ademuri/kelvin-kontroller/hardware/ref/kelvin-kontroller back.png

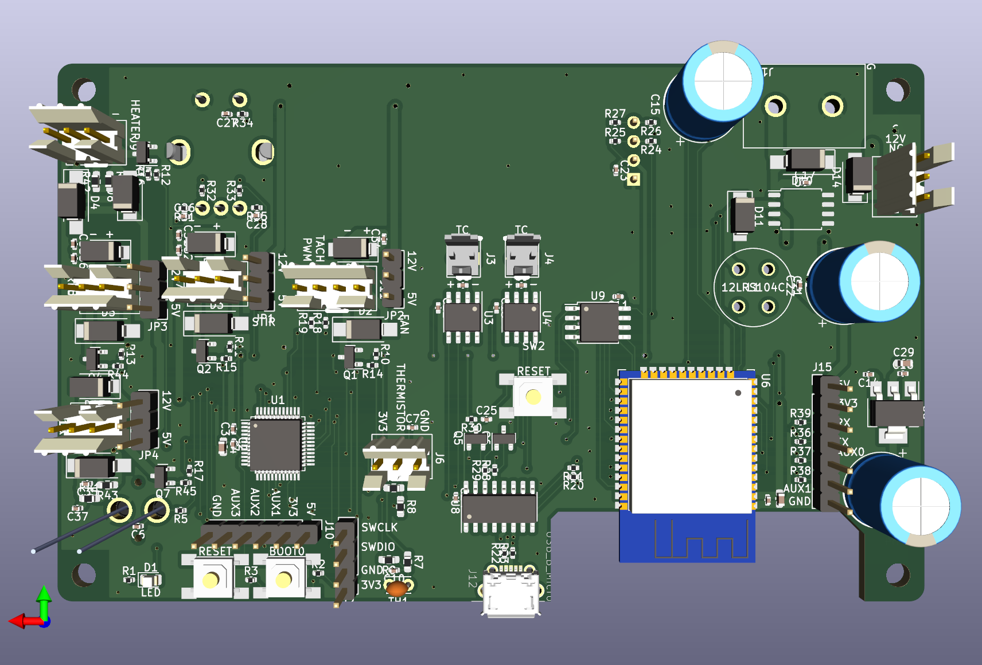
hardware/ref/kelvin-kontroller back.png
