ademuri/kelvin-kontroller/README.md

# Kelvin Kontroller

DIY coffee roaster. Custom PCB which controls and monitors the roaster. Has a WiFi dashboard.
