ademuri/kelvin-kontroller/hardware/ref/calculations.md

SSR safety: https://www.ia.omron.com/product/cautions/18/safety_precautions.html

Bleeder resistor:
R <= E / (I_L - I) = 0.5 / (1 uA - ??) -> 0.5 / (1 uA) = 500k
