ademuri/kelvin-kontroller/hardware/ref/kelvin-kontroller front.png

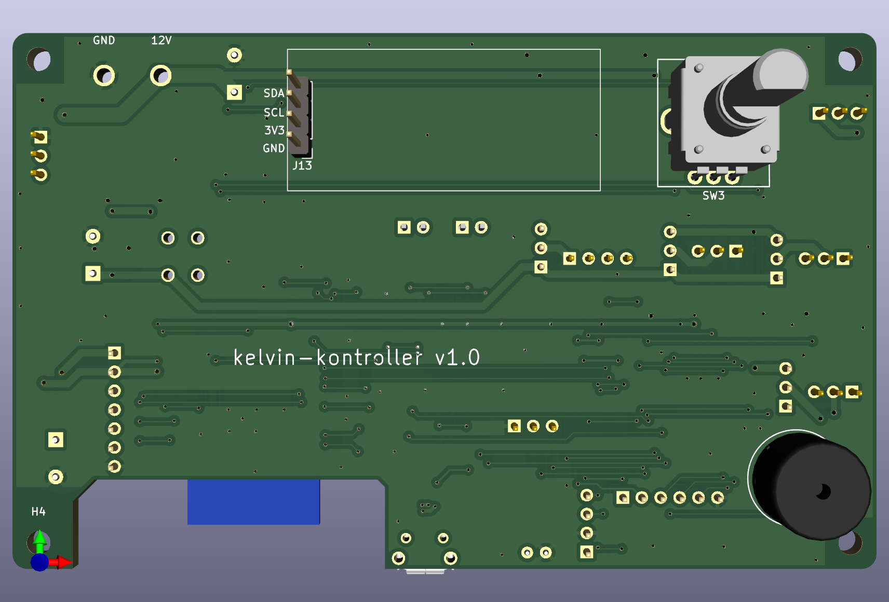
hardware/ref/kelvin-kontroller front.png
