ademuri/kelvin-kontroller/hardware/ref/kelvin-kontroller-controller.pdf

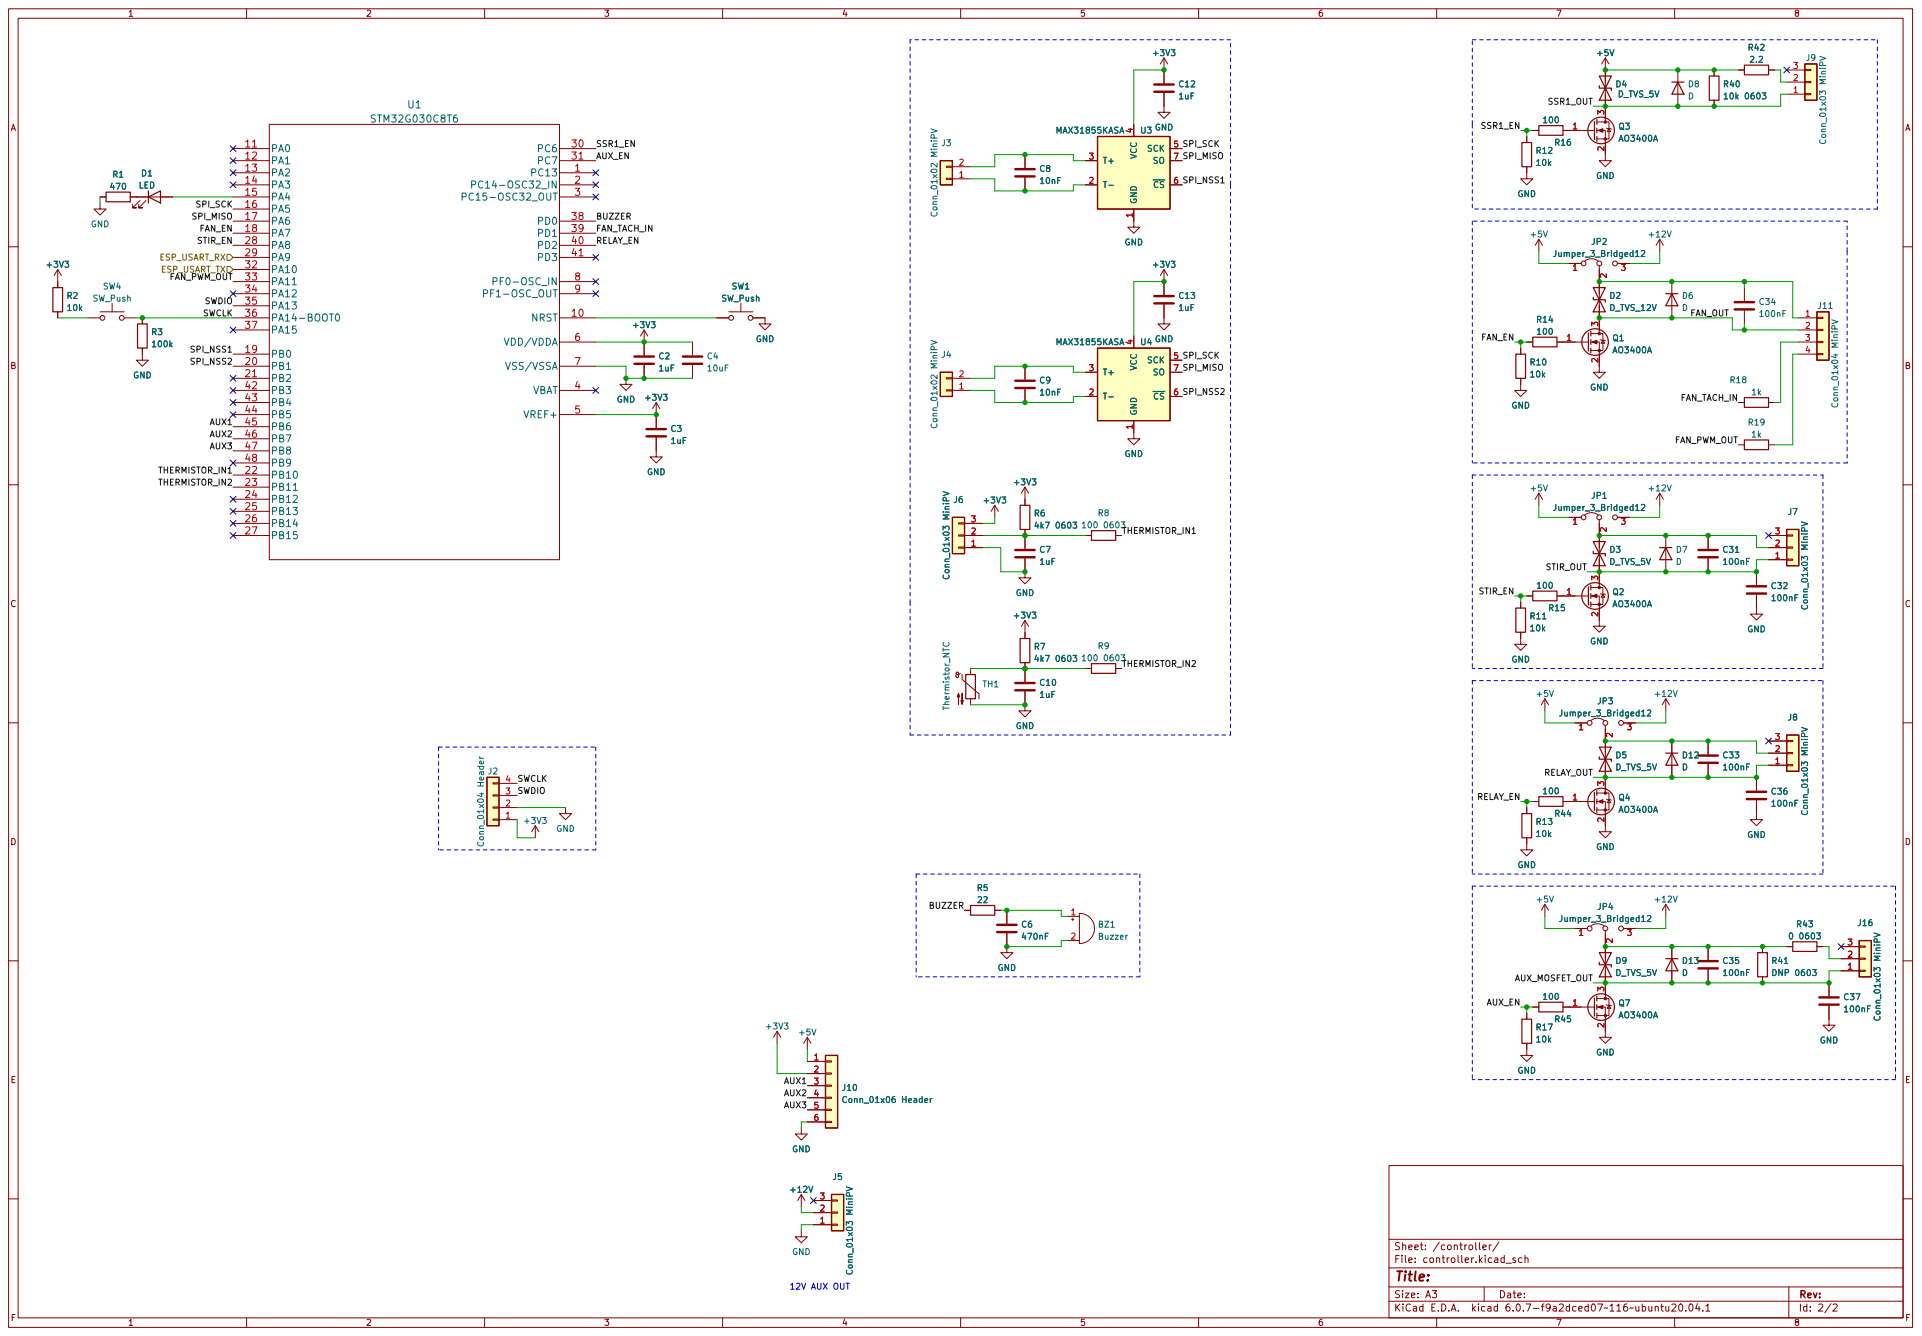
[picture p3: page 1]

File: controller.kicad_sch Sheet: /controller/
