ademuri/kelvin-kontroller/hardware/ref/kelvin-kontroller.pdf

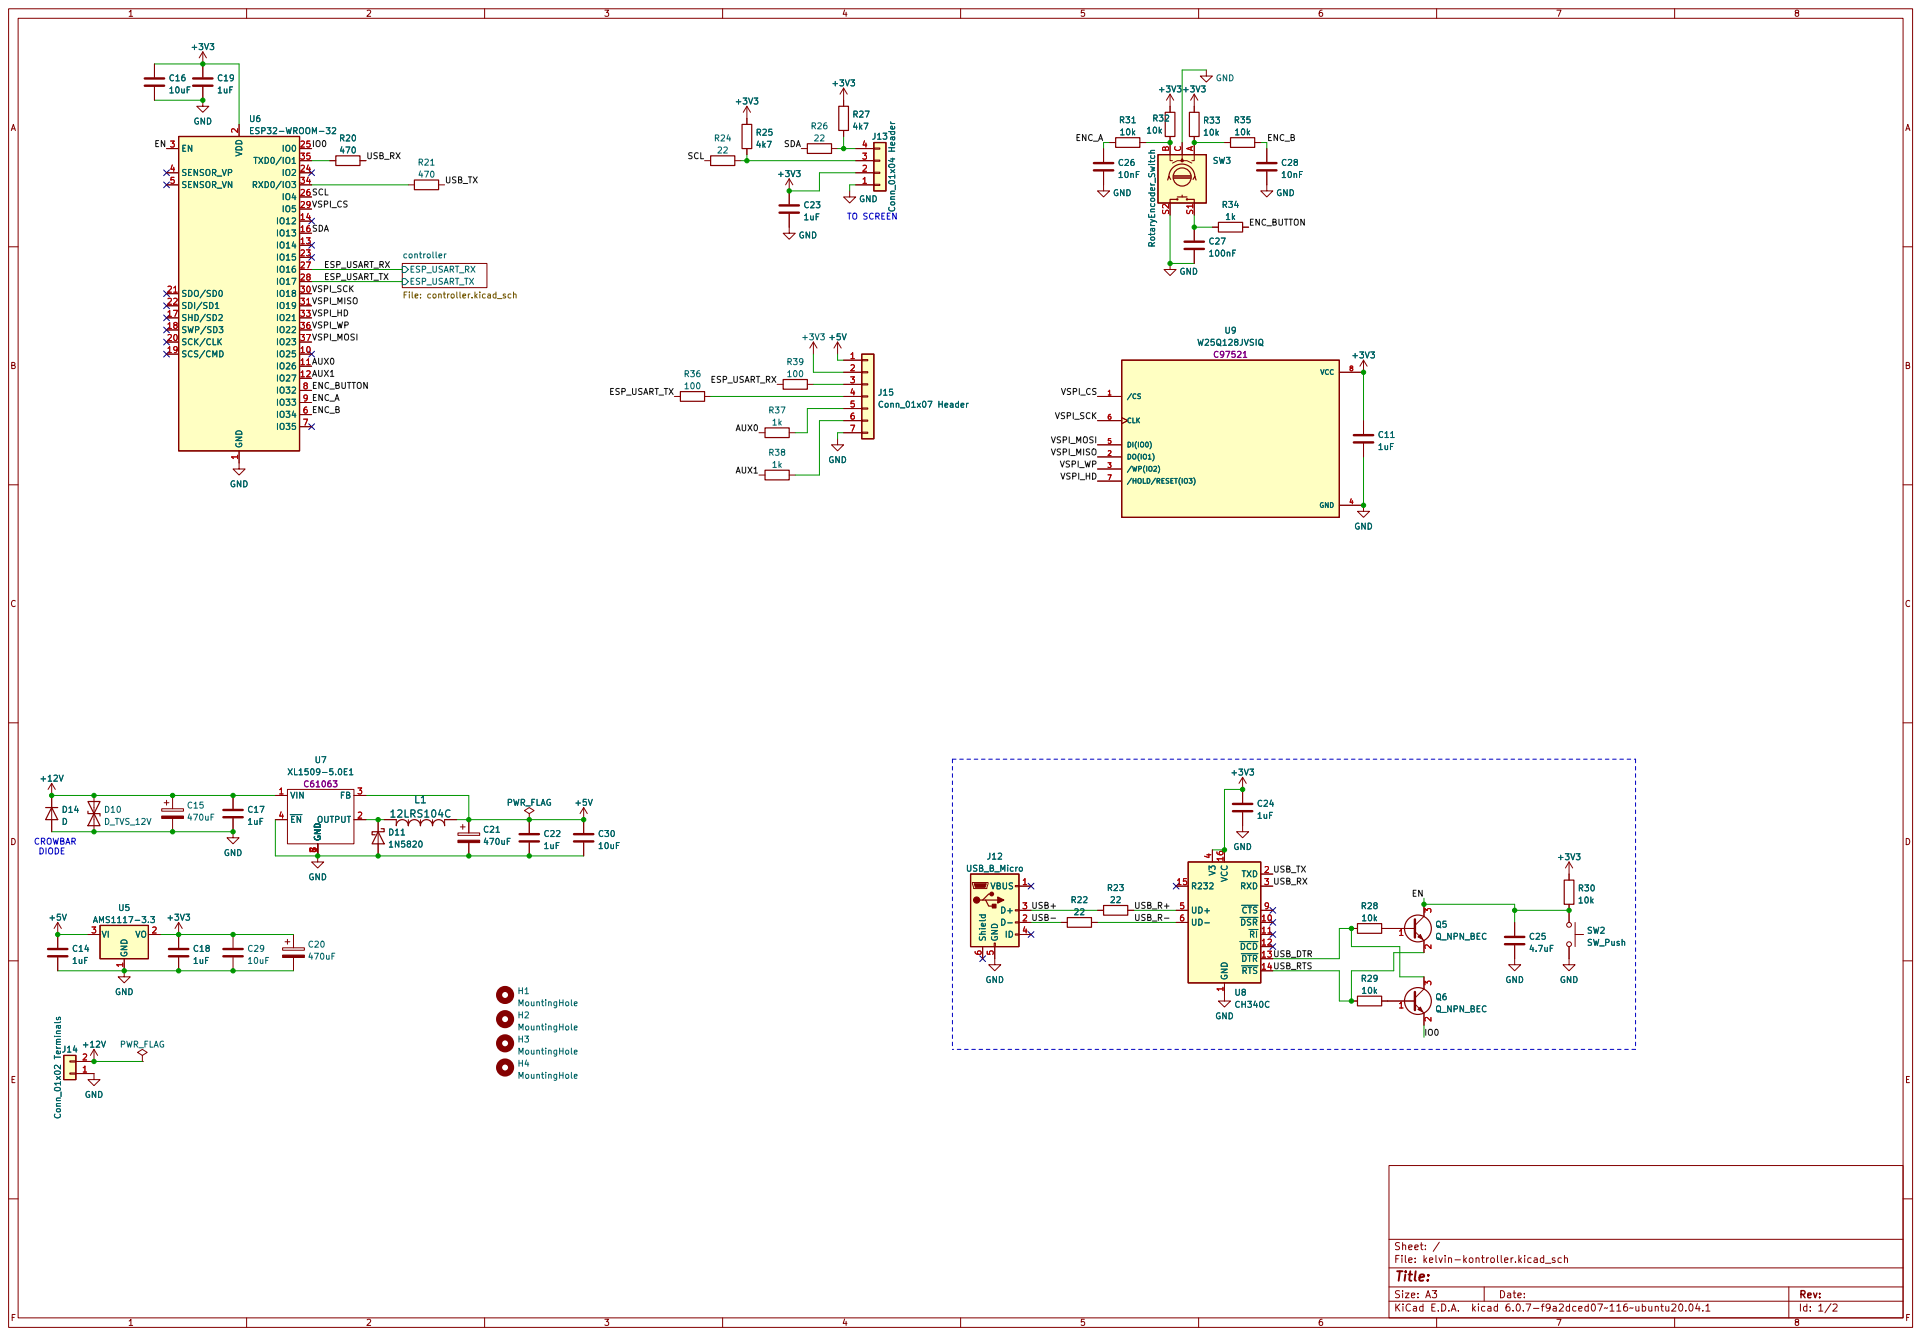
[picture p4: page 1]

2 SCK/CLK 20 SDO/SD0 21 SDI/SD1 22

1 ~{DSR}10 ~{RI}11 ~{DCD}12 ~{DTR}13 ~{RTS}14 R232 15 VCC 16 TXD 2 RXD 3 V3

4 UD+ 5 UD- 6 ~{CTS} 9 U8CH340C GND

4 UD+ 5 UD- 6 ~{CTS} 9 GND

File: kelvin-kontroller.kicad_sch Sheet: /


File: controller.kicad_sch Sheet: /controller/
