ademuri/kelvin-kontroller/hardware/kelvin-kontroller.kicad_pcb

## KiCad design hardware/kelvin-kontroller.kicad_pcb (2025-01-26)

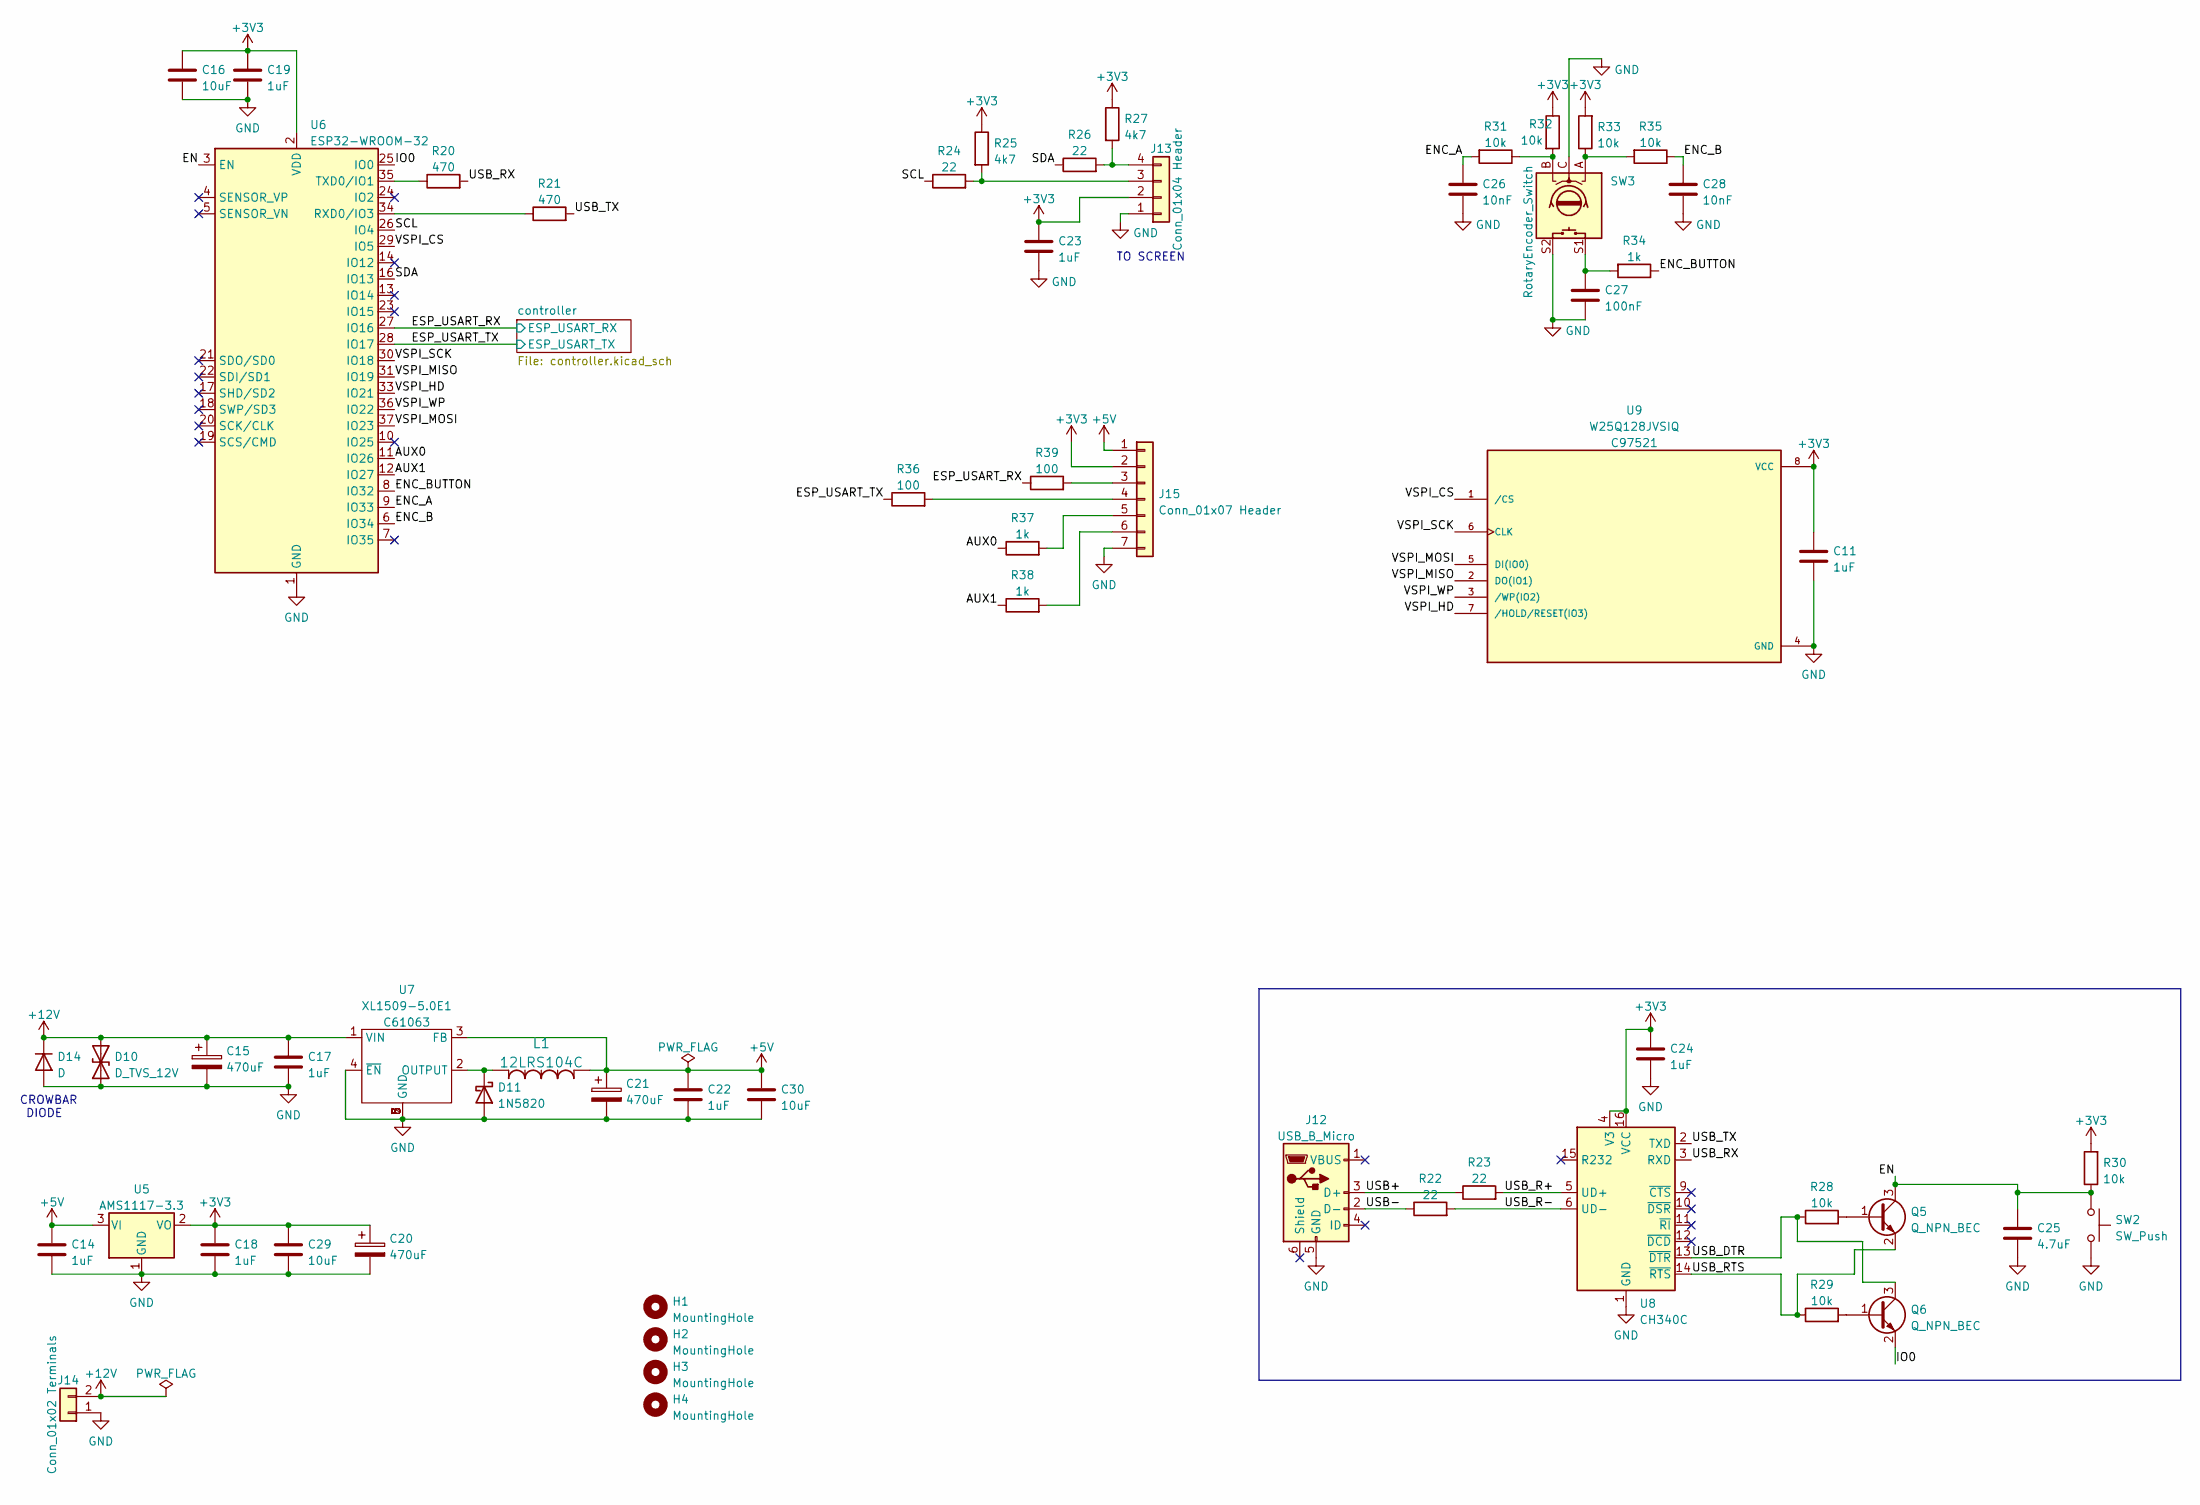
[picture p5: schematic kelvin-kontroller.kicad_sch]

Parts:
C11, C14, C17, C18, C19, C22, C23, C24: 1uF; C_0402_1005Metric; LCSC C52923
C15, C20, C21: 470uF; CP_Radial_D10.0mm_P5.00mm; MPN 25PK1000MEFC10X16
C16, C29, C30: 10uF; C_0603_1608Metric; LCSC C96446
C25: 4.7uF; C_0402_1005Metric; LCSC C23733
C26, C28: 10nF; C_0402_1005Metric; LCSC C15195
C27: 100nF; C_0402_1005Metric; LCSC C307331
D10: D_TVS_12V; D_SMA_Handsoldering; MPN 824501131
D11: 1N5820; D_SMA; LCSC C8678
D14: D; D_SMA; LCSC C8678
H1, H2, H3, H4: MountingHole; MountingHole_3.2mm_M3
J12: USB_B_Micro; FRAMATOME_10118194-0001LF_fixed_bridges; LCSC C132563
J13: Conn_01x04 Header; PinHeader_1x04_P2.54mm_Vertical
J14: Conn_01x02 Terminals; Amphenol_BarrierStrip_YK321020XX00G_1x02_P7.62; MPN YK3210203000G
J15: Conn_01x07 Header; PinHeader_1x07_P2.54mm_Vertical
L1: 12LRS104C; MPN 12LRS104C
Q5, Q6: Q_NPN_BEC; SOT-23; LCSC C2150
R20, R21: 470; R_0402_1005Metric; LCSC C25117
R22, R23, R24, R26: 22; R_0402_1005Metric; LCSC C25092
R25, R27: 4k7; R_0402_1005Metric; LCSC C25900
R28, R29, R30, R31, R32, R33, R35: 10k; R_0402_1005Metric; LCSC C25744
R34, R37, R38: 1k; R_0402_1005Metric; LCSC C11702
R36, R39: 100; R_0402_1005Metric; LCSC C25076
SW2: SW_Push; SW_TACTILE_5.1MM_TS-1187A-C-D-B; LCSC C318884
SW3: RotaryEncoder_Switch; BOURNS_PEC12R-4xxxF-Sxxxx; MPN PEC12R-4230F-S0024
U5: AMS1117-3.3; SOT-223-3_TabPin2; LCSC C6186
U6: ESP32-WROOM-32
U7: XL1509-5.0E1; SOIC-8_5.23x5.23mm_P1.27mm; LCSC C61063
U8: CH340C; SOIC-16_3.9x9.9mm_P1.27mm; LCSC C84681
U9: W25Q128JVSIQ; SOIC-8_5.275x5.275mm_P1.27mm; PARTREV I; LCSC C97521

Connections:
+3V3: C11.1, C16.1, C18.1, C19.1, C20.1, C23.1, C24.1, C29.1, J13.2, J15.2, R25.1, R27.1, R30.2, R32.1, R33.2, U5.2 (VO), U6.2 (VDD), U8.4 (V3), U8.16 (VCC), U9.8 (VCC); also elsewhere on the board
+5V: C14.1, C21.1, C22.1, C30.1, J15.1, L1.3, U5.3 (VI), U7.3 (FB); also elsewhere on the board
+12V: C15.1, C17.1, D10.2 (A2), D14.1 (K), J14.2, U7.1 (VIN); also elsewhere on the board
/AUX0: R37.1, U6.11 (IO26)
/AUX1: R38.1, U6.12 (IO27)
/EN: C25.1, Q5.3 (C), R30.1, SW2.1, U6.3 (EN)
/ENC_A: C26.1, R31.2, U6.9 (IO33)
/ENC_B: C28.1, R35.1, U6.6 (IO34)
/ENC_BUTTON: R34.1, U6.8 (IO32)
/ESP_USART_RX: R39.1, U6.27 (IO16); also elsewhere on the board
/ESP_USART_TX: R36.1, U6.28 (IO17); also elsewhere on the board
/IO0: Q6.2 (E), U6.25 (IO0)
/SCL: R24.1, U6.26 (IO4)
/SDA: R26.1, U6.16 (IO13)
/USB+: J12.3 (D+), R23.1
/USB-: J12.2 (D-), R22.1
/USB_DTR: Q6.3 (C), R28.1, U8.13 (~DTR)
/USB_R+: R23.2, U8.5 (UD+)
/USB_R-: R22.2, U8.6 (UD-)
/USB_RTS: Q5.2 (E), R29.1, U8.14 (~RTS)
/USB_RX: R20.2, U8.3 (RXD)
/USB_TX: R21.2, U8.2 (TXD)
/VSPI_CS: U6.29 (IO5), U9.1 (/CS)
/VSPI_HD: U6.33 (IO21), U9.7 (/HOLD/RESET(IO3))
/VSPI_MISO: U6.31 (IO19), U9.2 (DO(IO1))
/VSPI_MOSI: U6.37 (IO23), U9.5 (DI(IO0))
/VSPI_SCK: U6.30 (IO18), U9.6 (CLK)
/VSPI_WP: U6.36 (IO22), U9.3 (/WP(IO2))
GND: C11.2, C14.2, C15.2, C16.2, C17.2, C18.2, C19.2, C20.2, C21.2, C22.2, C23.2, C24.2, C25.2, C26.2, C27.2, C28.2, C29.2, C30.2, D10.1 (A1), D11.2 (A), D14.2 (A), J12.5 (GND), J13.1, J14.1, J15.7, SW2.2, SW3.C, SW3.S2, U5.1 (GND), U6.1 (GND), U6.15 (GND), U6.38 (GND), U6.39 (GND), U7.4 (~EN), U7.5 (GND), U7.6 (GND), U7.7 (GND), U7.8 (GND), U8.1 (GND), U9.4 (GND); also elsewhere on the board
unnamed: C27.1, R34.2, SW3.S1
unnamed: D11.1 (K), L1.1, U7.2 (OUTPUT)
unnamed: J13.3, R24.2, R25.2
unnamed: J13.4, R26.2, R27.2
unnamed: J15.3, R39.2
unnamed: J15.4, R36.2
unnamed: J15.5, R37.2
unnamed: J15.6, R38.2
unnamed: Q5.1 (B), R28.2
unnamed: Q6.1 (B), R29.2
unnamed: R20.1, U6.35 (TXD0/IO1)
unnamed: R21.1, U6.34 (RXD0/IO3)
unnamed: R31.1, R32.2, SW3.B
unnamed: R33.1, R35.2, SW3.A

Notes on the sheet:
CROWBAR DIODE
TO SCREEN

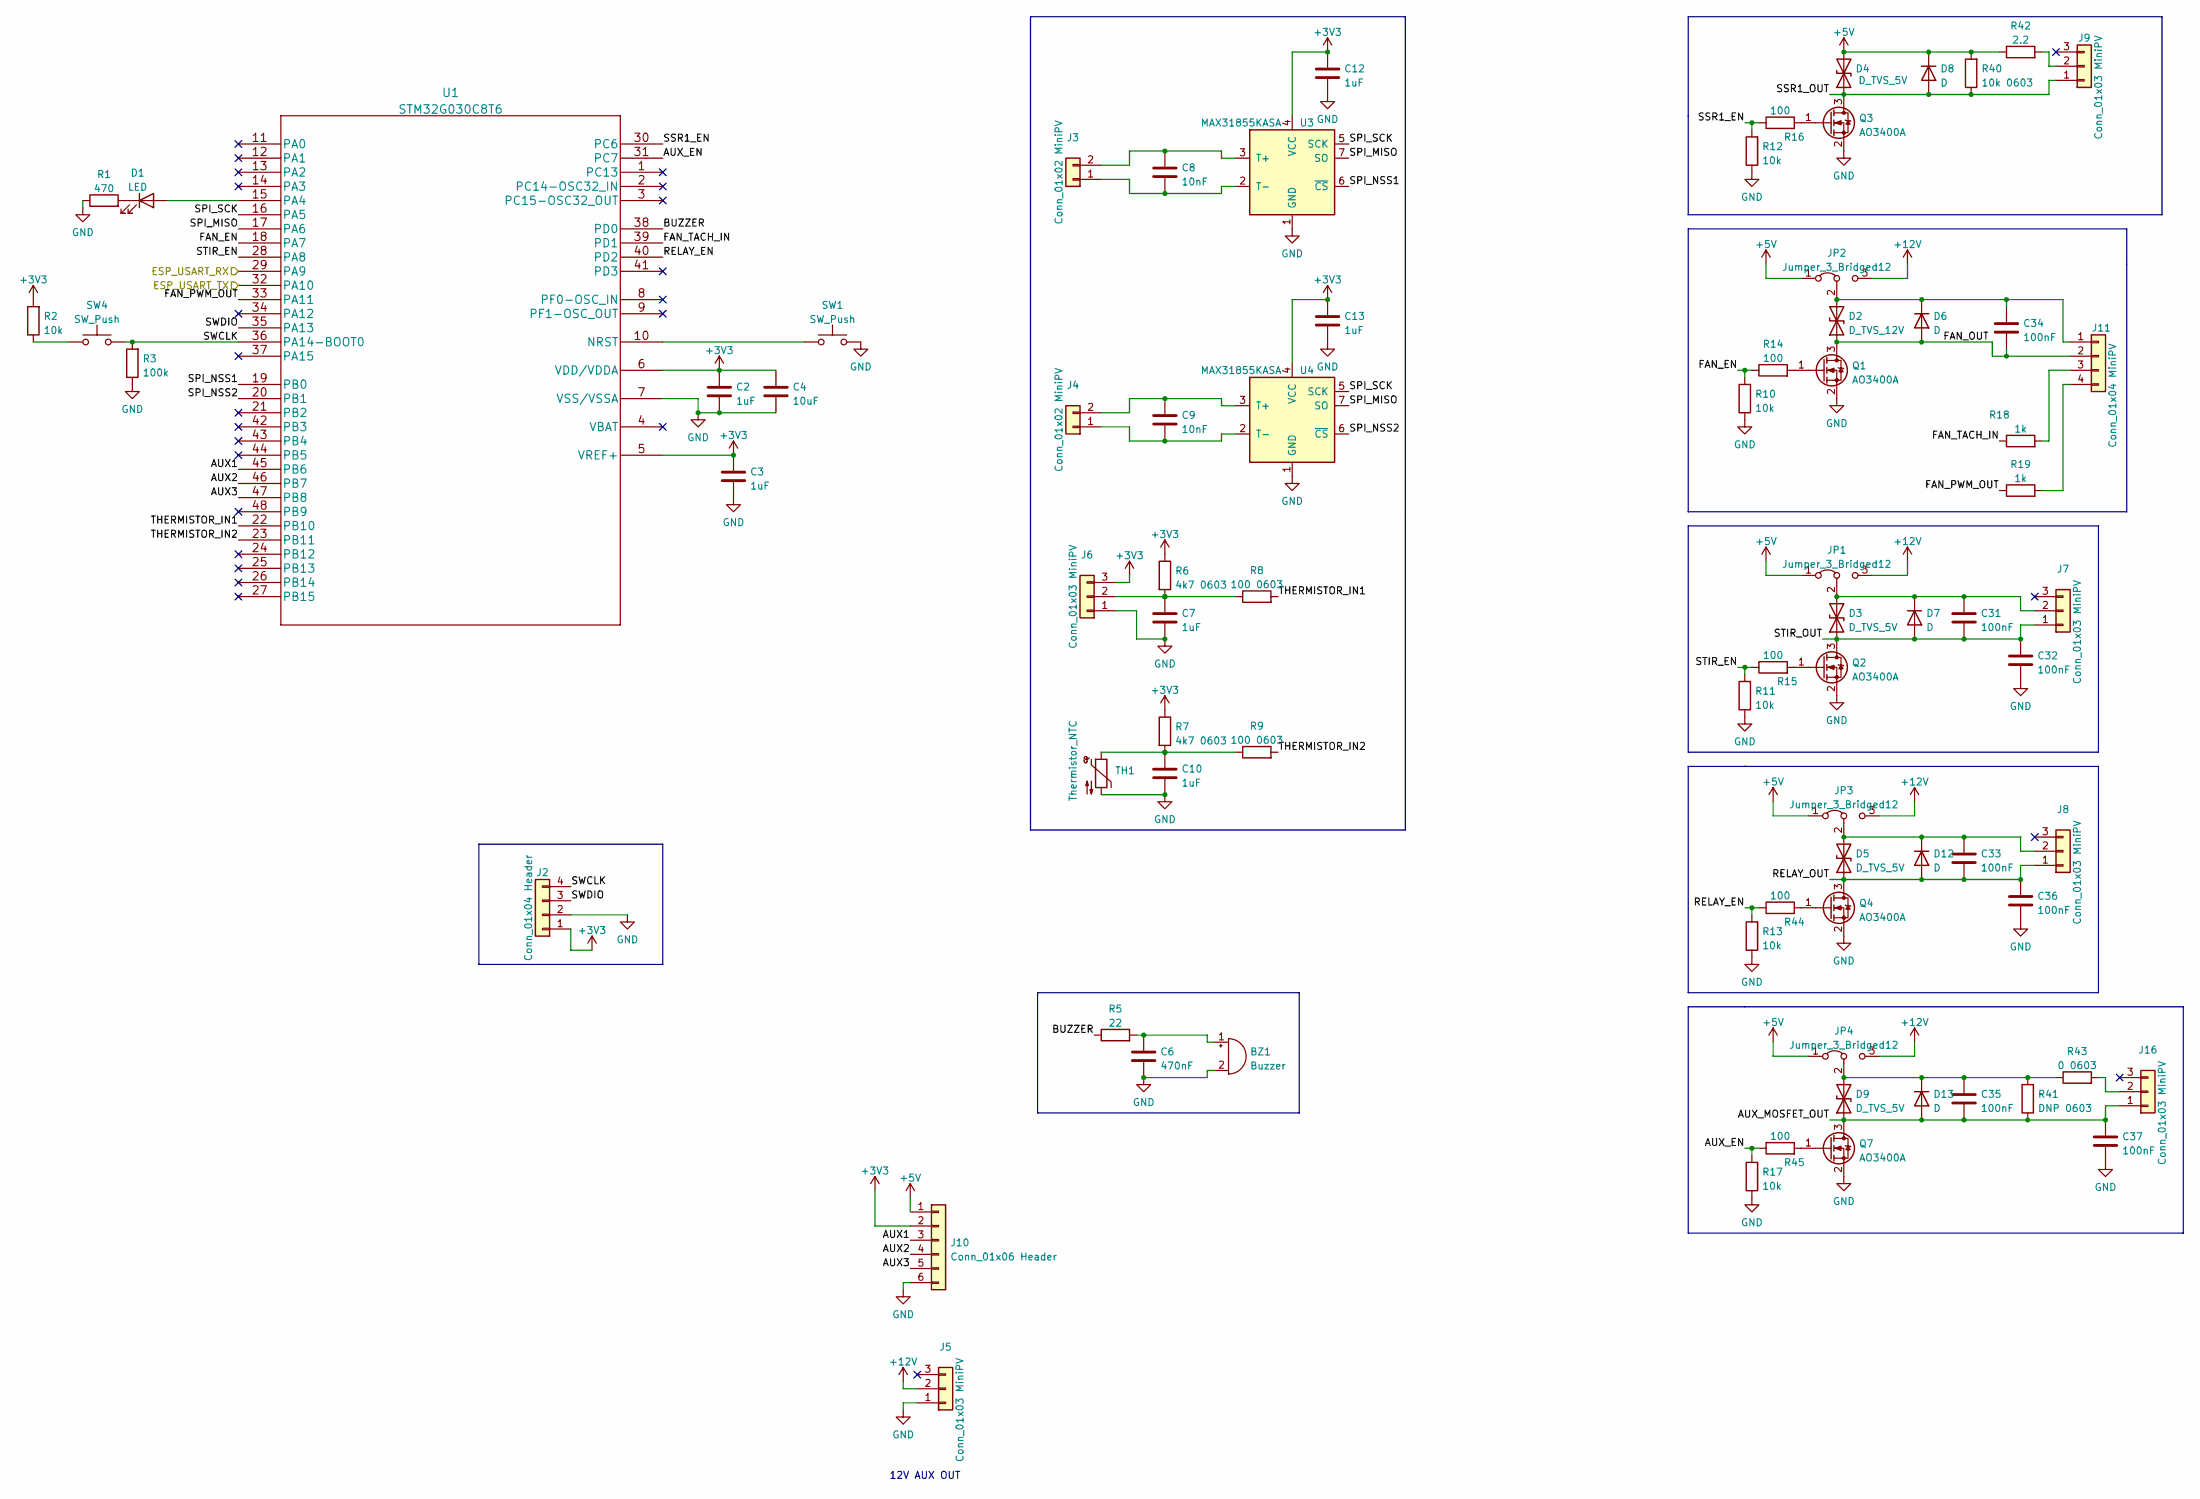
[picture p6: schematic controller.kicad_sch]

Parts:
BZ1: Buzzer; MURATA_PKM13EPYH4000-A0; MPN PKM13EPYH4000-A0
C2, C3, C7, C10, C12, C13: 1uF; C_0402_1005Metric; LCSC C52923
C4: 10uF; C_0603_1608Metric; LCSC C96446
C6: 470nF; C_0402_1005Metric; LCSC C47339
C8, C9: 10nF; C_0402_1005Metric; LCSC C15195
C31, C32, C33, C34, C35, C36, C37: 100nF; C_0402_1005Metric; LCSC C307331
D1: LED; LED_0805_2012Metric; LCSC C84256
D2: D_TVS_12V; D_SMA_Handsoldering; MPN 824501131
D3, D4, D5, D9: D_TVS_5V; D_SMA_Handsoldering; MPN 824501600
D6, D7, D8, D12, D13: D; D_SMA; LCSC C8678
J2: Conn_01x04 Header; PinHeader_1x04_P2.54mm_Vertical
J3, J4: Conn_01x02 MiniPV; MiniPV_76384-X02XX_1x02_P2.54mm_Vertical
J5, J6, J7, J8, J9, J16: Conn_01x03 MiniPV; MiniPV_69167-X03XXX_1x03_P2.54mm_Polarized_Vertical
J10: Conn_01x06 Header; PinHeader_1x06_P2.54mm_Vertical
J11: Conn_01x04 MiniPV; MiniPV_69167-X04XXX_1x04_P2.54mm_Polarized_Vertical
JP1, JP2, JP3, JP4: Jumper_3_Bridged12; PinHeader_1x03_P2.54mm_Vertical
Q1, Q2, Q3, Q4, Q7: AO3400A; SOT-23; LCSC C20917
R1: 470; R_0402_1005Metric; LCSC C25117
R2, R10, R11, R12, R13, R17: 10k; R_0402_1005Metric; LCSC C25744
R3: 100k; R_0402_1005Metric; LCSC C25741
R5: 22; R_0402_1005Metric; LCSC C25092
R6, R7: 4k7 0603; R_0603_1608Metric_Pad0.98x0.95mm_HandSolder; LCSC C23162
R8, R9: 100 0603; R_0603_1608Metric_Pad0.98x0.95mm_HandSolder; LCSC C22775
R14, R15, R16, R44, R45: 100; R_0402_1005Metric; LCSC C25076
R18, R19: 1k; R_0402_1005Metric; LCSC C11702
R40: 10k 0603; R_0603_1608Metric_Pad0.98x0.95mm_HandSolder; LCSC C25804
R41: DNP 0603; R_0603_1608Metric_Pad0.98x0.95mm_HandSolder; LCSC C25804
R42: 2.2; R_0603_1608Metric_Pad0.98x0.95mm_HandSolder; LCSC C22939
R43: 0 0603; R_0603_1608Metric_Pad0.98x0.95mm_HandSolder; LCSC C22939
SW1, SW4: SW_Push; SW_TACTILE_5.1MM_TS-1187A-C-D-B; LCSC C318884
TH1: Thermistor_NTC; C_Disc_D3.0mm_W2.0mm_P2.50mm; MPN NXRT15XH103FA1B030
U1: STM32G030C8T6; LQFP-48_7x7mm_P0.5mm; LCSC C529329
U3, U4: MAX31855KASA; SOIC-8_3.9x4.9mm_P1.27mm; LCSC C52028

Connections:
+3V3: C2.1, C3.1, C4.1, C12.1, C13.1, J2.1, J6.3, J10.2, R2.2, R6.1, R7.1, U1.5 (VREF+), U1.6 (VDD/VDDA), U3.4 (VCC), U4.4 (VCC); also elsewhere on the board
+5V: D4.2 (A2), D8.1 (K), J10.1, JP1.1 (A), JP2.1 (A), JP3.1 (A), JP4.1 (A), R40.2, R42.1; also elsewhere on the board
+12V: J5.2, JP1.3 (B), JP2.3 (B), JP3.3 (B), JP4.3 (B); also elsewhere on the board
/ESP_USART_RX: U1.29 (PA9); also elsewhere on the board
/ESP_USART_TX: U1.32 (PA10); also elsewhere on the board
/controller/AUX1: J10.3, U1.45 (PB6)
/controller/AUX2: J10.4, U1.46 (PB7)
/controller/AUX3: J10.5, U1.47 (PB8)
/controller/AUX_EN: R17.2, R45.1, U1.31 (PC7)
/controller/AUX_MOSFET_OUT: C35.2, C37.1, D9.1 (A1), D13.2 (A), J16.1, Q7.3 (D), R41.1
/controller/BUZZER: R5.1, U1.38 (PD0)
/controller/FAN_EN: R10.2, R14.1, U1.18 (PA7)
/controller/FAN_OUT: C34.2, D2.1 (A1), D6.2 (A), J11.2, Q1.3 (D)
/controller/FAN_PWM_OUT: R19.1, U1.33 (PA11)
/controller/FAN_TACH_IN: R18.1, U1.39 (PD1)
/controller/RELAY_EN: R13.2, R44.1, U1.40 (PD2)
/controller/RELAY_OUT: C33.2, C36.1, D5.1 (A1), D12.2 (A), J8.1, Q4.3 (D)
/controller/SPI_MISO: U1.17 (PA6), U3.7 (SO), U4.7 (SO)
/controller/SPI_NSS1: U1.19 (PB0), U3.6 (~CS)
/controller/SPI_NSS2: U1.20 (PB1), U4.6 (~CS)
/controller/SPI_SCK: U1.16 (PA5), U3.5 (SCK), U4.5 (SCK)
/controller/SSR1_EN: R12.2, R16.1, U1.30 (PC6)
/controller/SSR1_OUT: D4.1 (A1), D8.2 (A), J9.1, Q3.3 (D), R40.1
/controller/STIR_EN: R11.2, R15.1, U1.28 (PA8)
/controller/STIR_OUT: C31.2, C32.1, D3.1 (A1), D7.2 (A), J7.1, Q2.3 (D)
/controller/SWCLK: J2.4, R3.2, SW4.2, U1.36 (PA14-BOOT0)
/controller/SWDIO: J2.3, U1.35 (PA13)
/controller/THERMISTOR_IN1: R8.2, U1.22 (PB10)
/controller/THERMISTOR_IN2: R9.2, U1.23 (PB11)
GND: BZ1.2 (+), C2.2, C3.2, C4.2, C6.2, C7.2, C10.2, C12.2, C13.2, C32.2, C36.2, C37.2, J2.2, J5.1, J6.1, J10.6, Q1.2 (S), Q2.2 (S), Q3.2 (S), Q4.2 (S), Q7.2 (S), R1.1, R3.1, R10.1, R11.1, R12.1, R13.1, R17.1, SW1.2, TH1.2, U1.7 (VSS/VSSA), U3.1 (GND), U4.1 (GND); also elsewhere on the board
unnamed: BZ1.1 (-), C6.1, R5.2
unnamed: C7.1, J6.2, R6.2, R8.1
unnamed: C8.1, J3.2, U3.3 (T+)
unnamed: C8.2, J3.1, U3.2 (T-)
unnamed: C9.1, J4.2, U4.3 (T+)
unnamed: C9.2, J4.1, U4.2 (T-)
unnamed: C10.1, R7.2, R9.1, TH1.1
unnamed: C31.1, D3.2 (A2), D7.1 (K), J7.2, JP1.2 (C)
unnamed: C33.1, D5.2 (A2), D12.1 (K), J8.2, JP3.2 (C)
unnamed: C34.1, D2.2 (A2), D6.1 (K), J11.1, JP2.2 (C)
unnamed: C35.1, D9.2 (A2), D13.1 (K), JP4.2 (C), R41.2, R43.1
unnamed: D1.1 (K), R1.2
unnamed: D1.2 (A), U1.15 (PA4)
unnamed: J9.2, R42.2
unnamed: J11.3, R18.2
unnamed: J11.4, R19.2
unnamed: J16.2, R43.2
unnamed: Q1.1 (G), R14.2
unnamed: Q2.1 (G), R15.2
unnamed: Q3.1 (G), R16.2
unnamed: Q4.1 (G), R44.2
unnamed: Q7.1 (G), R45.2
unnamed: R2.1, SW4.1
unnamed: SW1.1, U1.10 (NRST)

Notes on the sheet:
12V AUX OUT

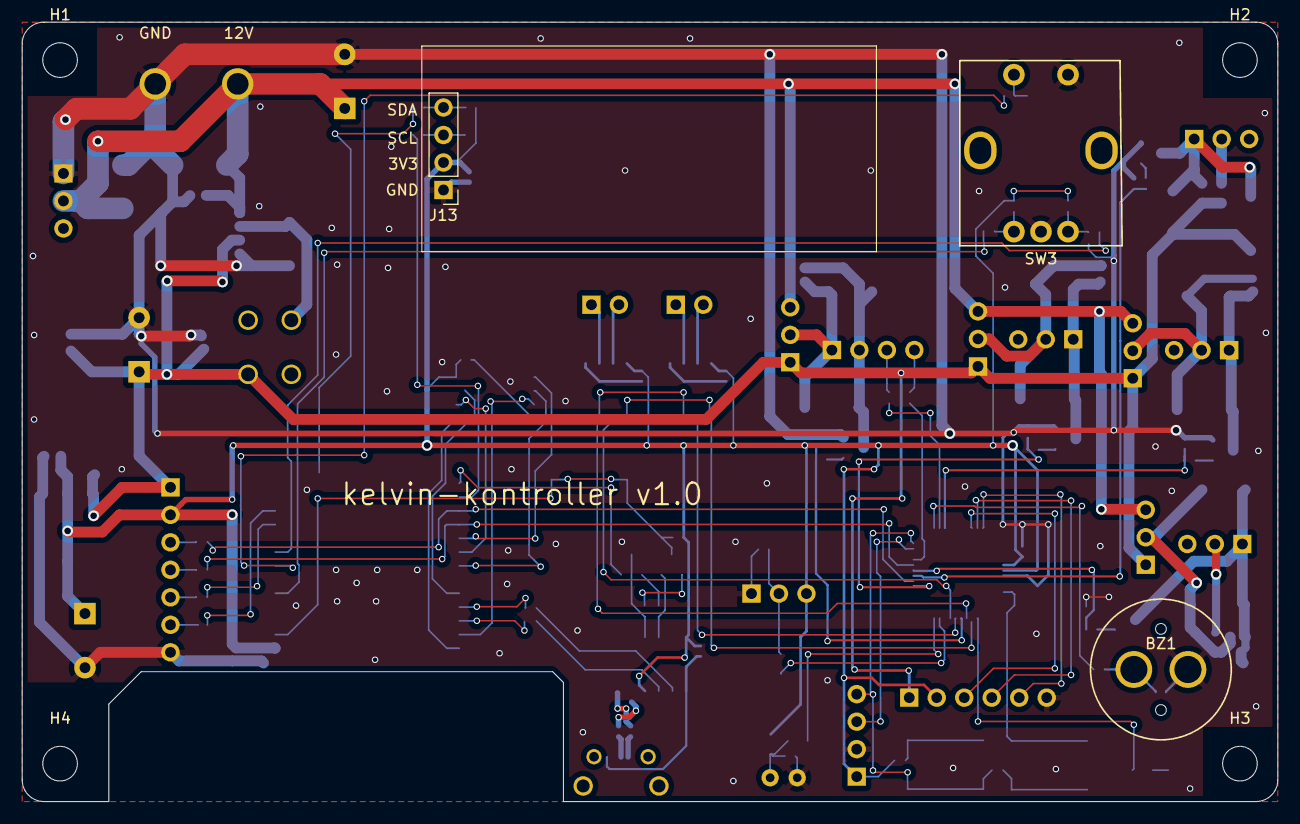
[picture p7: board kelvin-kontroller.kicad_pcb from above]

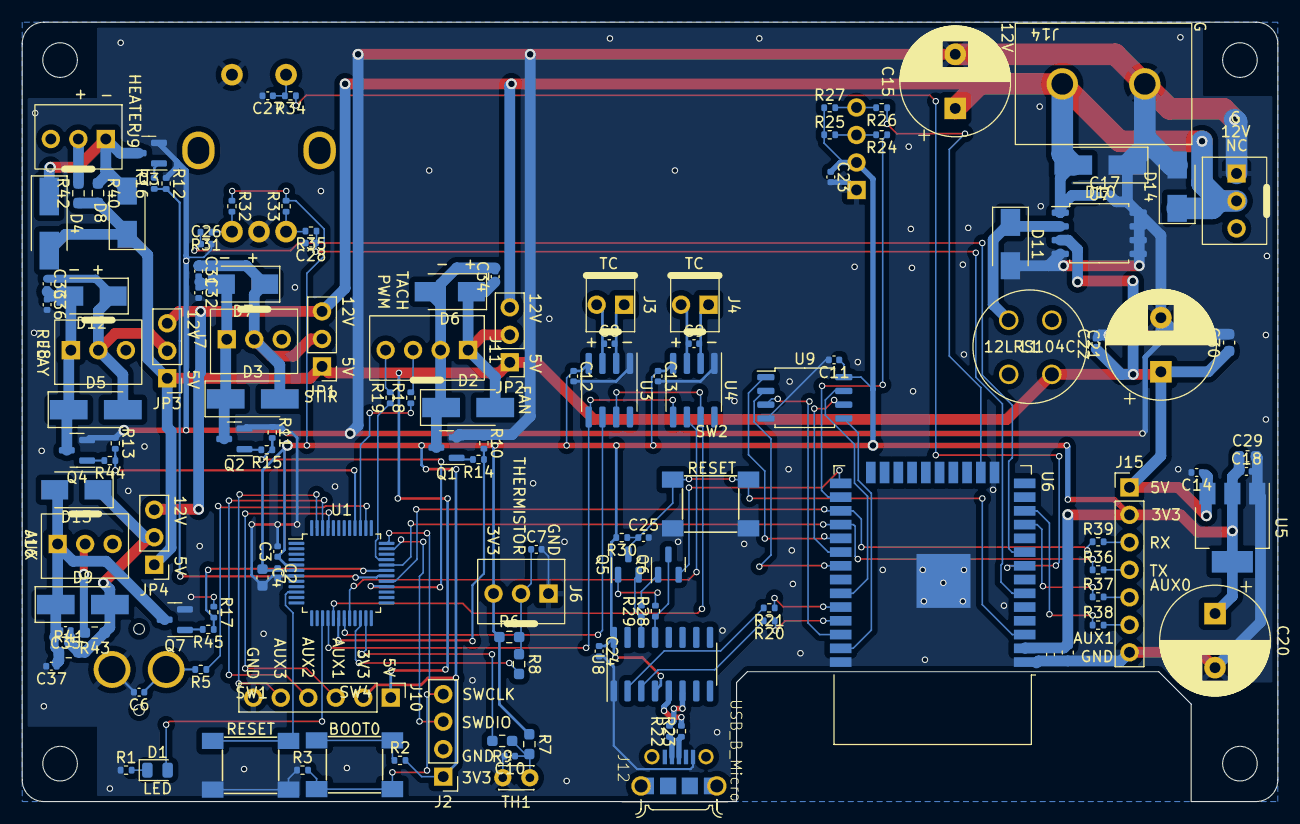
[picture p8: board kelvin-kontroller.kicad_pcb from below]

Board: 2 copper layers, 116.0 x 72.0 mm, 138 parts (131 on the bottom side), 91 nets.
