ademuri/kelvin-kontroller/(commit log)

2022-10-03 Start adding schematic
    [controller.kicad_sch, kelvin-kontroller.kicad_pcb, kelvin-kontroller.kicad_sch]
2022-10-04 Add KiCAD gitignore
2022-10-04 Continue schematic - finish controller and add LCD
    [controller.kicad_sch, kelvin-kontroller.kicad_sch]
2022-10-05 Schematic nearly finished
    [controller.kicad_sch, kelvin-kontroller.kicad_sch]
2022-10-06 Update schematic and part assignment
    [controller.kicad_sch, kelvin-kontroller.kicad_sch]
2022-10-07 Finish assigning footprints
    [controller.kicad_sch, kelvin-kontroller.kicad_sch]
2022-10-10 Start layout
    [controller.kicad_sch, kelvin-kontroller.kicad_pcb, kelvin-kontroller.kicad_sch]
2022-10-11 Add internal thermistor and change SSR2 -> mosfet
    [controller.kicad_sch, kelvin-kontroller.kicad_sch]
2022-10-11 Continue layout, add SPI flash
    [controller.kicad_sch, kelvin-kontroller.kicad_pcb, kelvin-kontroller.kicad_sch]
2022-10-12 Continue layout
    [controller.kicad_sch, kelvin-kontroller.kicad_pcb, kelvin-kontroller.kicad_sch]
2022-10-13 First pass at layout
    [controller.kicad_sch, kelvin-kontroller.kicad_pcb, kelvin-kontroller.kicad_sch]
2022-10-13 Start routing
    [kelvin-kontroller.kicad_pcb]
2022-10-14 Hardware revision v1.0
    [controller.kicad_sch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]
2022-10-16 Add pin definitions for stm32
2022-10-18 Add controls for heater, and min/max settings
2022-10-18 Start adding thermistor class (not working yet)
    [thermistor_test.cc]
2022-10-19 Fix thermistor and add Celsius/Fahrenheit methods
    [thermistor_test.cc]
2022-10-19 Format thermistor files
2022-10-20 Add function to read resistance to thermistor
2022-10-21 Initialize SPI
2022-10-21 Add filtering for temps
2022-10-22 Check that the controller turns on the relay at init
2022-10-22 Check for thermocouple read errors in controller
    [controller_test.cc]
2022-10-22 Change heater to be on/off in the controller
2022-10-25 Start adding websockets support
    Currently untested.
2022-10-26 Use easy transfer between esp32 and stm32
2022-10-27 Switch from websockets to modbus and implement read
2022-10-28 Revert "Mostly add modbus write"
    This reverts commit 60ff8b54a95f325f4c3ebfb928f32a231f997c20.
    [esp32.cc]
2022-10-28 Revert "Switch from websockets to modbus and implement read"
    This reverts commit 17dc94d3522de2c36d9289a8d3dcdf5e81051fe6.
    [esp32.cc]
2022-10-28 Add support for setting temp, fan, and reset over websockets
    [esp32.cc]
2022-10-30 Fix string constants definitions
    [esp32.cc]
2022-10-31 Updates from pcb testing:
    - Switch to defining serial port via flags
    - Don't use the thermocouples yet, as they do not work
    - Set nBOOT_SEL = 0, to make the BOOT0 button work
2022-10-31 Start adding STM32 flashing to ESP32
2022-10-31 Switch to fastified version of MAX31855 library
2022-11-01 Fix startup faults and commands
    [esp32.cc]
2022-11-05 Allow setting PID params from dashboard
2022-11-05 Decrease therm filter interval
2022-11-05 Allowed greater patch versions of esp32 lib deps
2022-11-05 Decrease therm filter run interval slightly
2022-11-05 Display heater output on graph
2022-11-05 Only enable heater if fan is on
2022-11-05 Prepare for PID tuning
2022-11-06 Stir when the temperature is above a threshold
2022-11-06 Set fan *target* from the command
2022-11-06 Run the fan while hot.
    Also add test coverage for stirring while hot.
2022-11-06 Report thermocouple error codes
    [esp32.cc]
2022-11-06 Seperate faults into since-reset and fatal
    [controller_test.cc, esp32.cc]
2023-03-11 Pin dep versions
2023-03-11 Update test temps to fix breakage from updated temp thresholds
    [controller_test.cc]
2023-03-11 Update KiCAD files to v7
    [controller.kicad_sch, kelvin-kontroller.kicad_pcb, kelvin-kontroller.kicad_sch]
2023-03-11 Migrate fan to be direct PWM
2023-03-13 Improve dashboard
    - Don't stomp on user changes to the graph scale
    - Make graph and controls side-by-side
    - Add button to reset the graph
    - Add header to CSV output
2023-03-13 Tune fan for direct fan control
2023-03-13 Increase noise filtering on thermocouples
2023-03-14 Save PID values to browser local storage
2023-03-14 Add roast progress buttons
2023-03-20 Add OTA support for ESP32
2023-03-20 Set the hostname for ArduinoOTA
2023-03-20 Implement curves on the esp32
2023-03-20 Fix curve implementation and silence debug serial messages by default
    [esp32.cc]
2023-03-20 Add curve stop and fix set temp display
    [esp32.cc]
2023-03-20 Add a button to go to the next curve point
2023-03-20 Reset the stm32 on esp32 boot
    [esp32.cc]
2023-03-23 Switch to pid on env temp
2023-03-23 Ignore relay status in shutdown logic
2023-03-23 Dashboard: cap temps and fix fan and set temp background updating
2023-03-23 Update PID test to use env temp
2023-03-23 Add delay between turning on fan and heater
2023-03-23 Ramp up the fan when turning it on
2023-04-21 Fix tests - account for fan ramping
    [controller_test.cc]
2023-05-06 Add support for manually overriding the heater output
2023-05-07 Make dashboard work with manually setting the heater
2023-10-07 Fix fault fan bug and auto-reset after fault
2024-11-06 Fix out-of-memory compile error
    [esp32.cc]
2024-11-07 Update dependencies for esp32
2024-11-07 Update timer library version
2025-01-26 Convert to KiCAD 8 and remove BOM files
    [controller.kicad_sch, kelvin-kontroller.kicad_pcb, kelvin-kontroller.kicad_sch, kelvin-kontroller_bom_jlc.csv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]
2025-01-26 Add .gitignore for KiCAD
